tomaszkowal/logic_nixie_clock/logic_nixie_clock.kicad_pcb

## KiCad design logic_nixie_clock.kicad_pcb (2026-10-22)

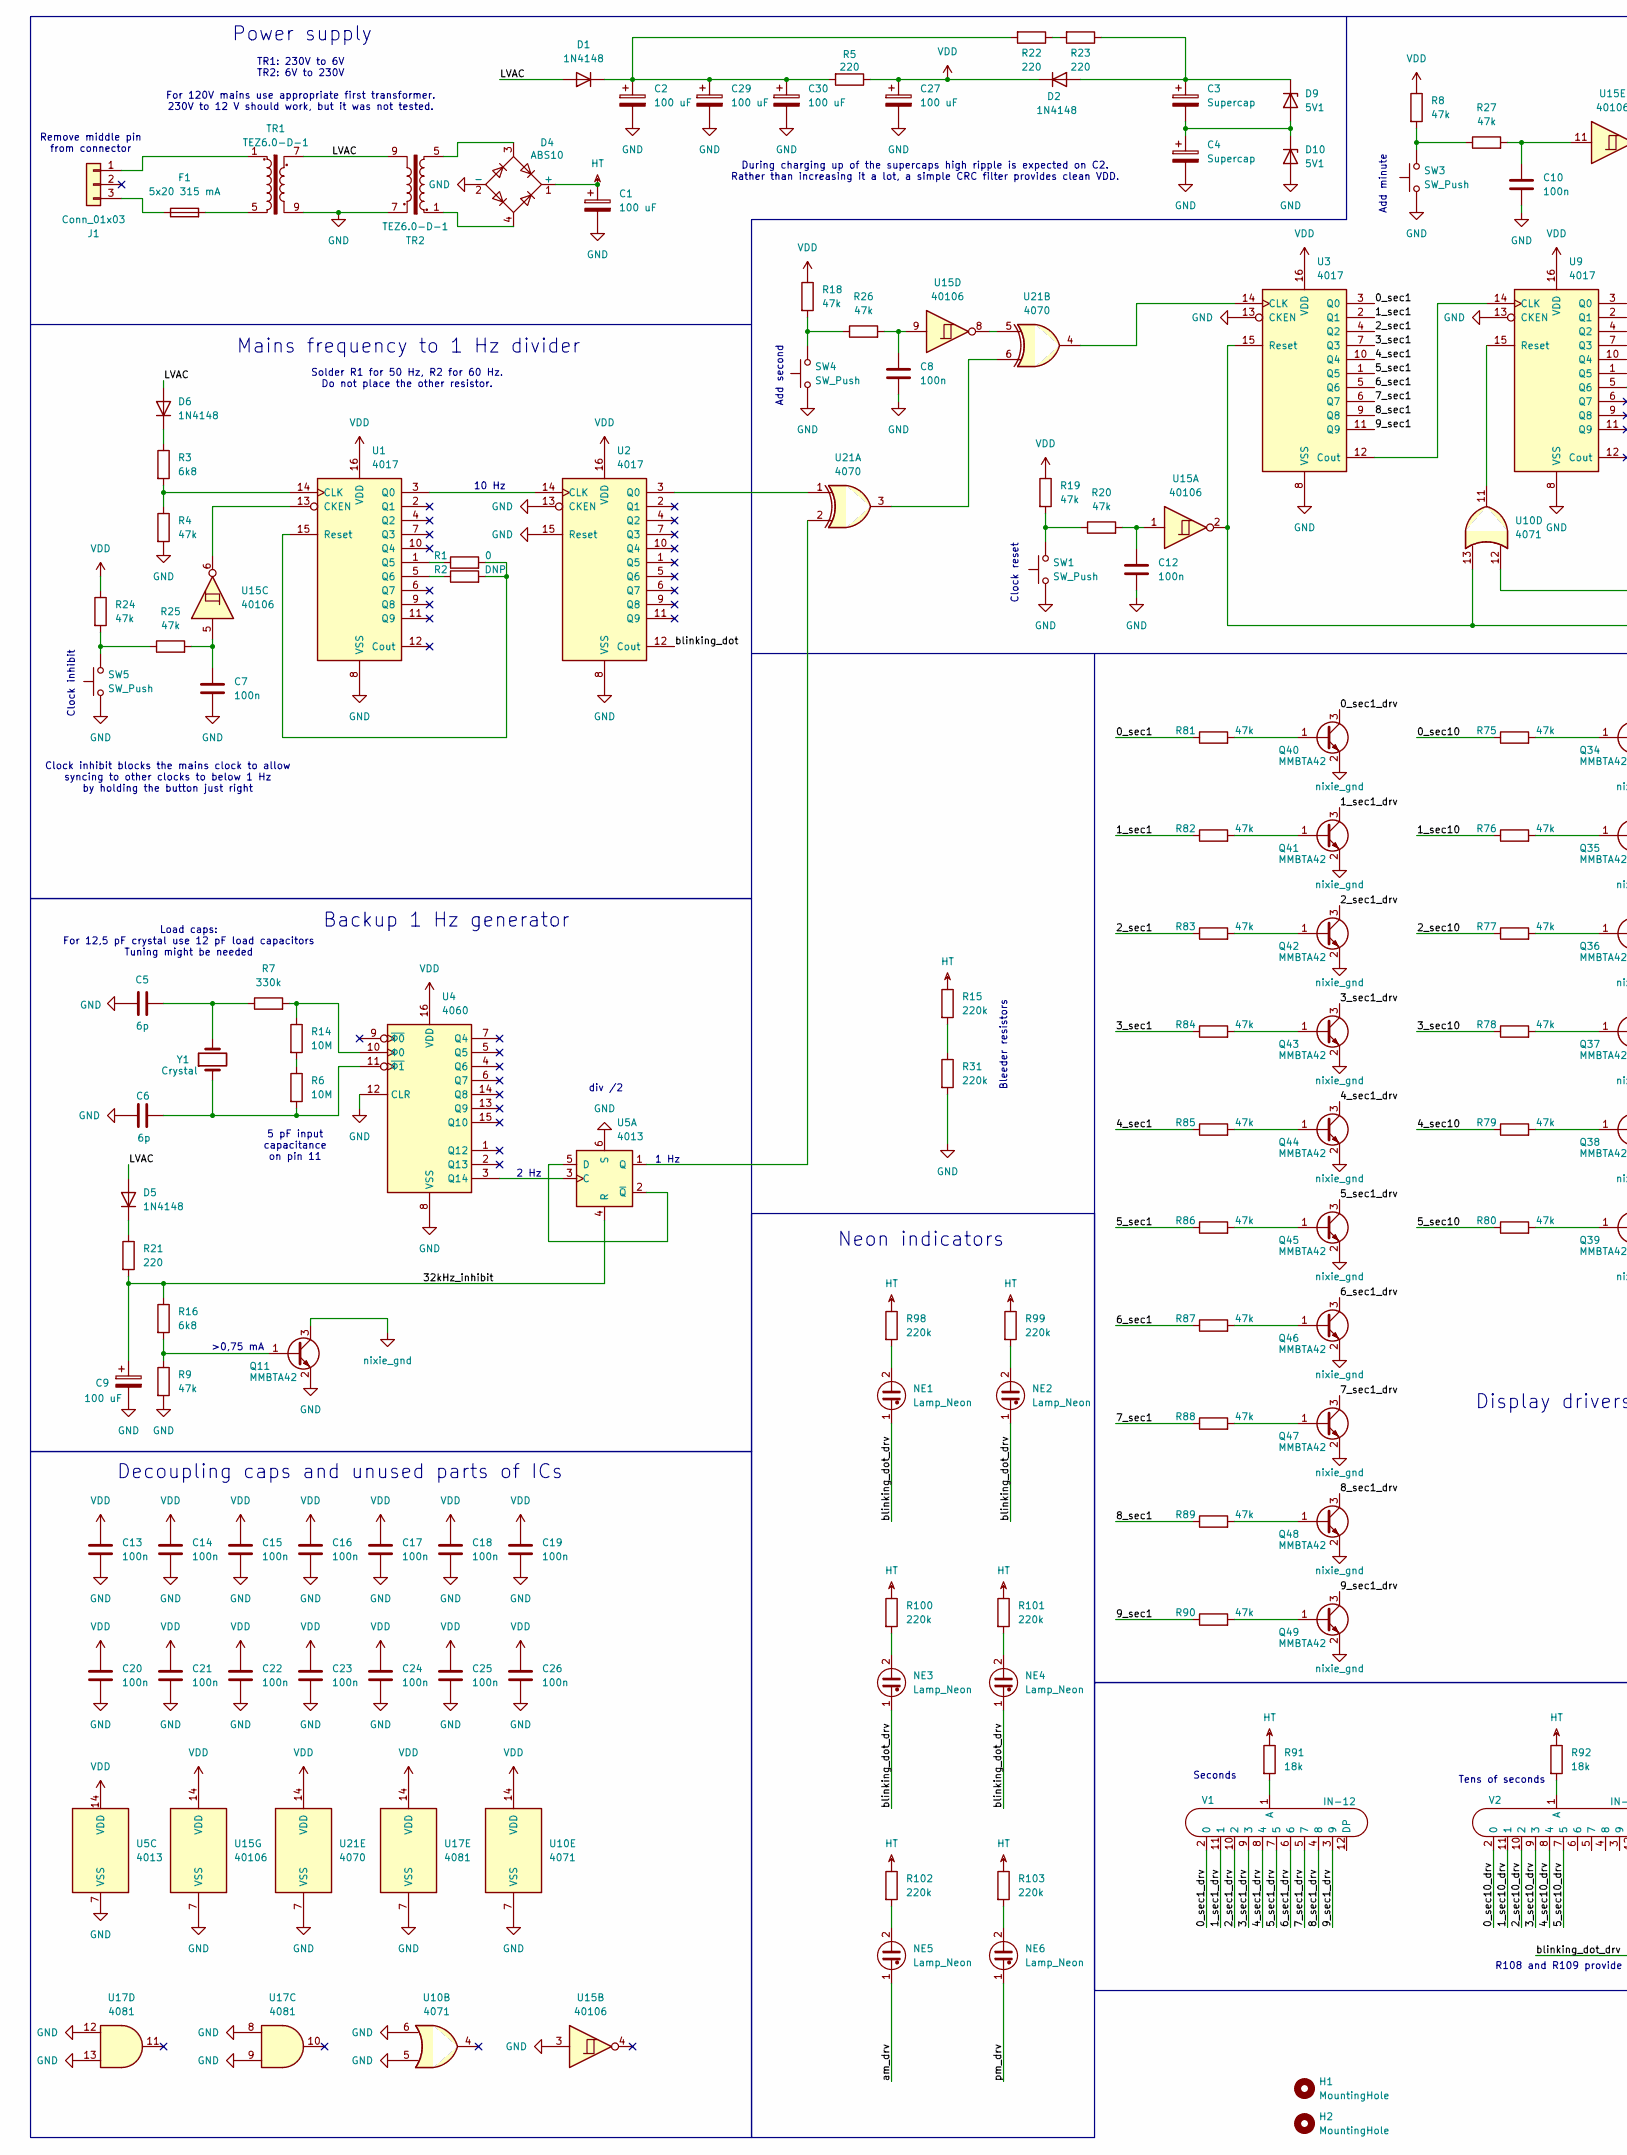
[picture p1: schematic logic_nixie_clock.kicad_sch, 4000 series logic nixie clock, part in row 1, column 1]

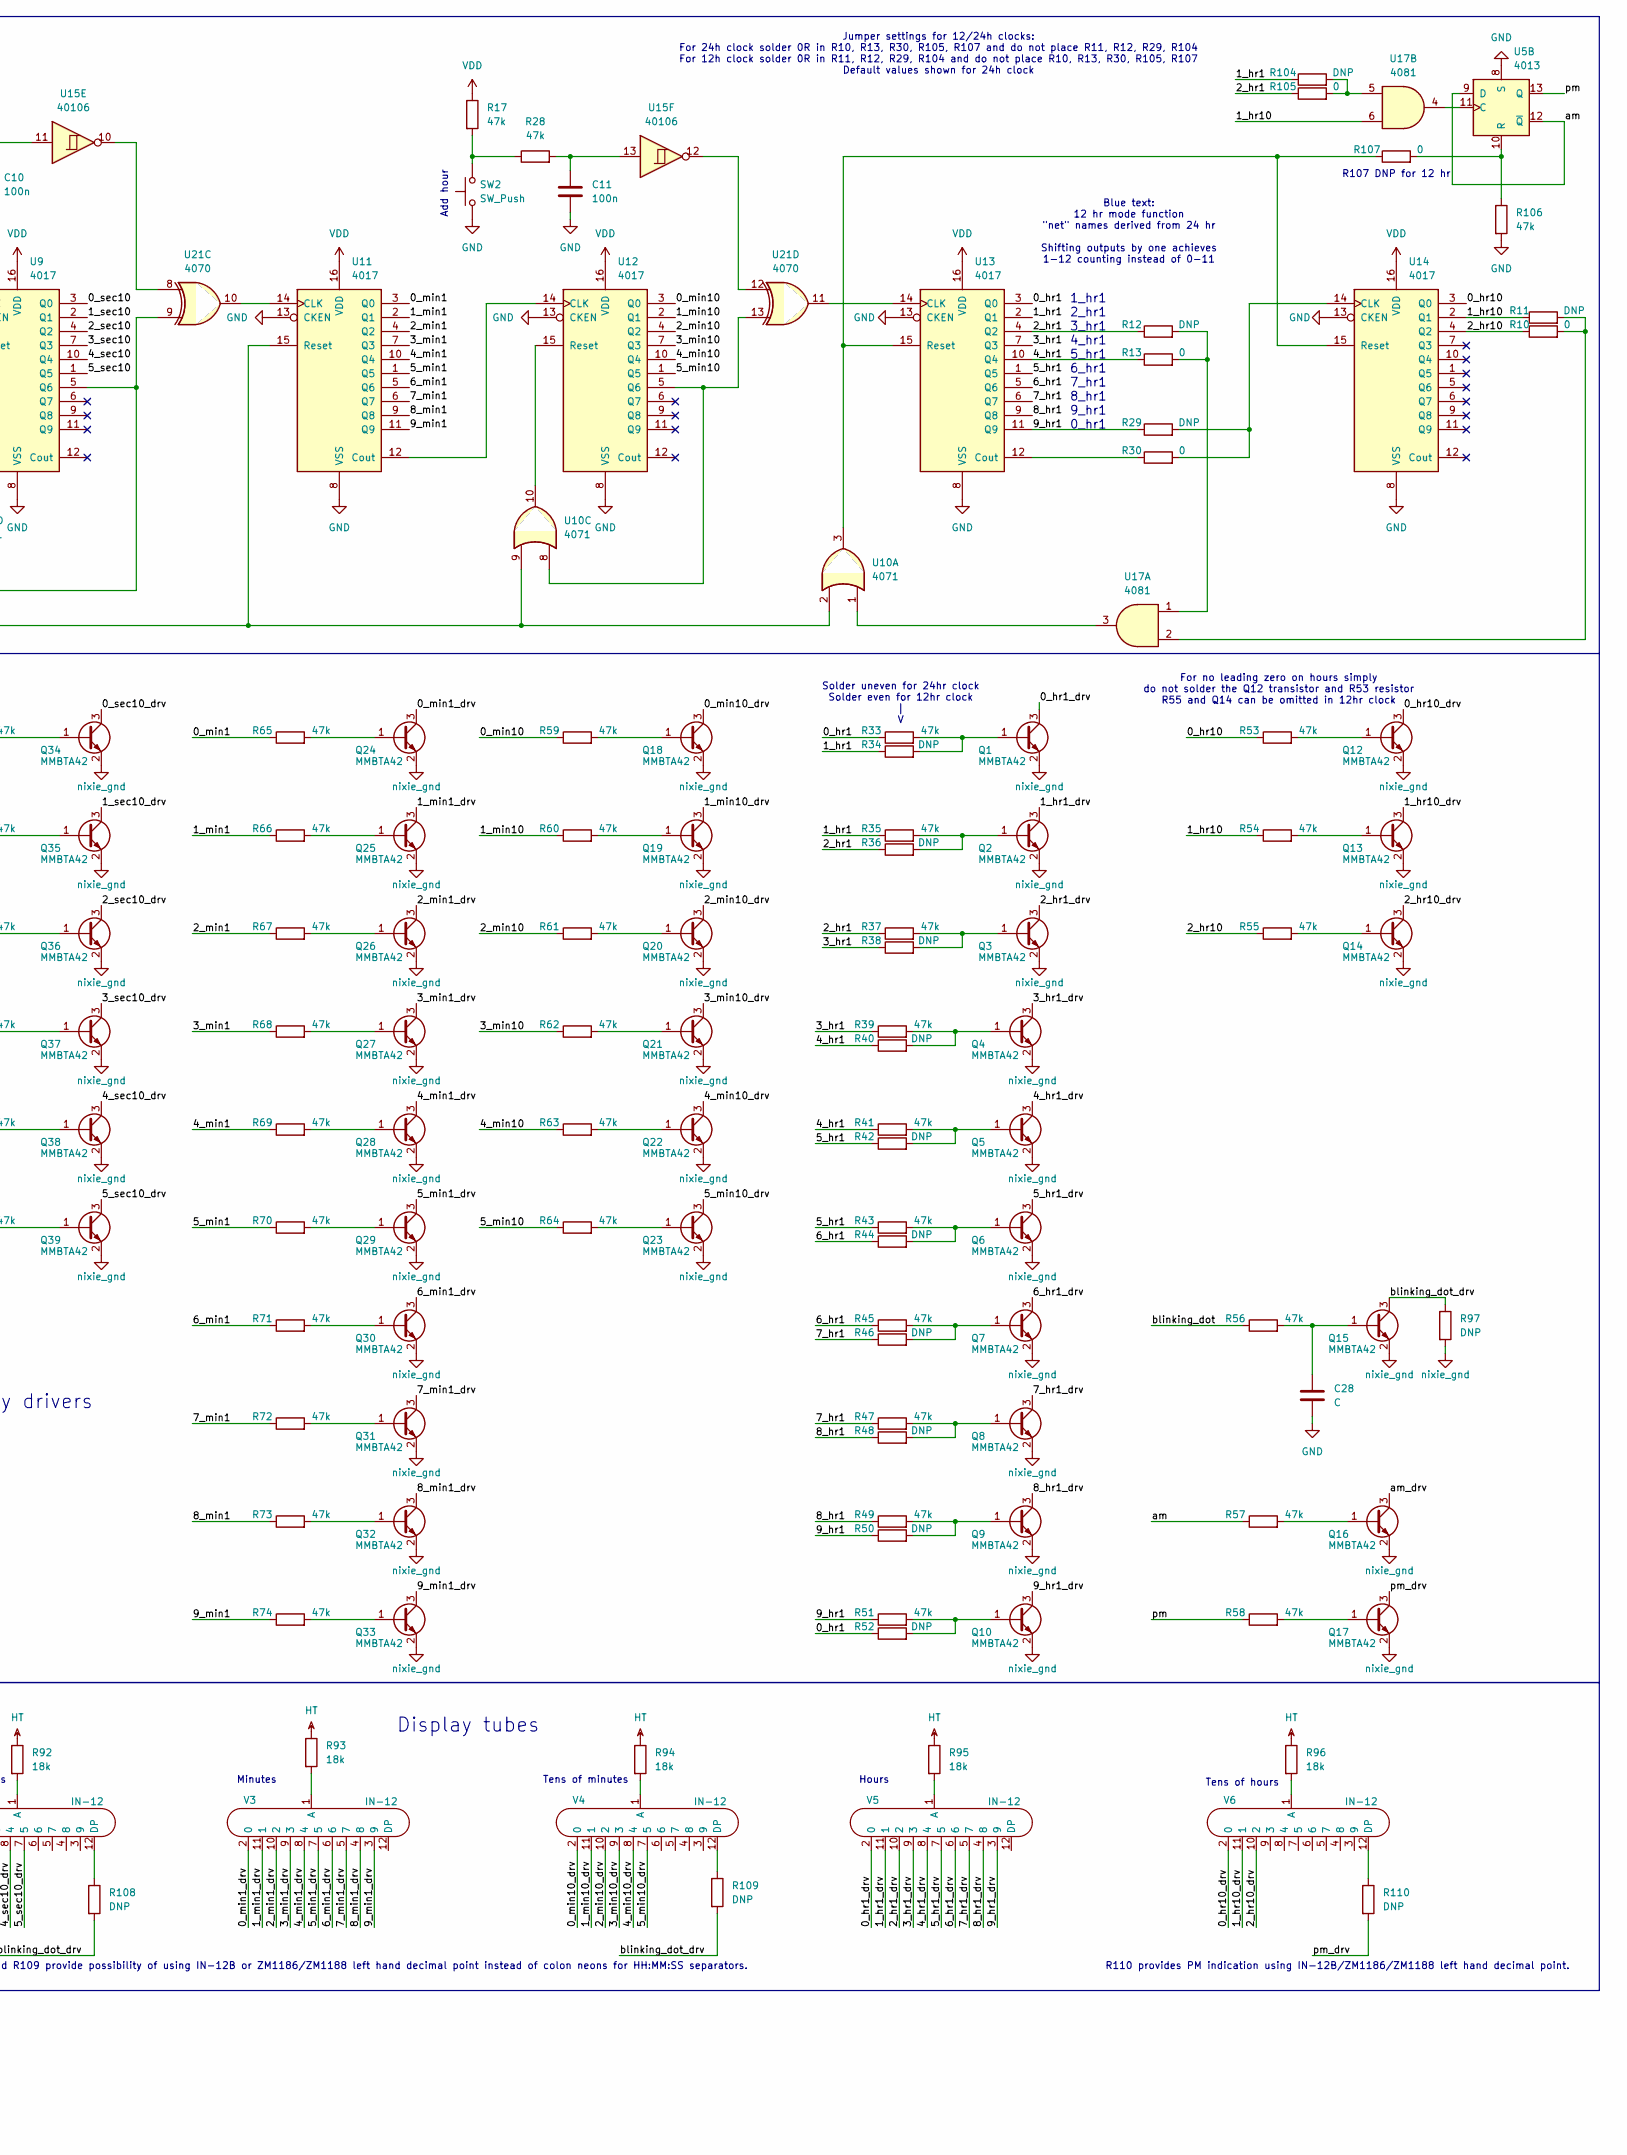
[picture p2: schematic logic_nixie_clock.kicad_sch, 4000 series logic nixie clock, part in row 1, column 2]

Parts:
C1: 100 uF; CP_Radial_D16.0mm_P7.50mm
C2, C9, C27, C29, C30: 100 uF; CP_Radial_D5.0mm_P2.00mm
C3, C4: Supercap; 17x25x8,5mm double supercapacitor
C5, C6: 6p; C_0805_2012Metric_Pad1.18x1.45mm_HandSolder
C7, C8, C10, C11, C12, C13, C14, C15, C16, C17, C18, C19, C20, C21, C22, C23, C24, C25, C26: 100n; C_0805_2012Metric_Pad1.18x1.45mm_HandSolder
C28: C; C_0805_2012Metric_Pad1.18x1.45mm_HandSolder
D1, D2, D5, D6: 1N4148; D_SOD-123F
D4: ABS10; Diode_Bridge_Diotec_ABS
D9, D10: 5V1; D_MiniMELF
F1: 5x20 315 mA; Fuseholder_Clip-5x20mm_Schurter_CQM_Inline_P20.60x5.00mm_D1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
H1, H2: MountingHole; MountingHole_3.2mm_M3
J1: Conn_01x03; JST_VH_B3P-VH-B_1x03_P3.96mm_Vertical
NE1, NE2, NE3, NE4, NE5, NE6: Lamp_Neon; NE-2 4mm
Q1, Q2, Q3, Q4, Q5, Q6, Q7, Q8, Q9, Q10, Q11, Q12, Q13, Q14, Q15, Q16, Q17, Q18, Q19, Q20, Q21, Q22, Q23, Q24, Q25, Q26, Q27, Q28, Q29, Q30, Q31, Q32, Q33, Q34, Q35, Q36, Q37, Q38, Q39, Q40, Q41, Q42, Q43, Q44, Q45, Q46, Q47, Q48, Q49: MMBTA42; SOT-23-3
R1, R10, R13, R30, R105, R107: 0; R_0805_2012Metric_Pad1.20x1.40mm_HandSolder
R2, R11, R12, R29, R34, R36, R38, R40, R42, R44, R46, R48, R50, R52, R97, R104: DNP; R_0805_2012Metric_Pad1.20x1.40mm_HandSolder
R3, R16: 6k8; R_0805_2012Metric_Pad1.20x1.40mm_HandSolder
R4, R8, R9, R17, R18, R19, R20, R24, R25, R26, R27, R28, R33, R35, R37, R39, R41, R43, R45, R47, R49, R51, R53, R54, R55, R56, R57, R58, R59, R60, R61, R62, R63, R64, R65, R66, R67, R68, R69, R70, R71, R72, R73, R74, R75, R76, R77, R78, R79, R80, R81, R82, R83, R84, R85, R86, R87, R88, R89, R90, R106: 47k; R_0805_2012Metric_Pad1.20x1.40mm_HandSolder
R5, R21, R22, R23: 220; R_0805_2012Metric_Pad1.20x1.40mm_HandSolder
R6, R14: 10M; R_0805_2012Metric_Pad1.20x1.40mm_HandSolder
R7: 330k; R_0805_2012Metric_Pad1.20x1.40mm_HandSolder
R15, R31, R98, R99, R100, R101, R102, R103: 220k; R_1206_3216Metric_Pad1.30x1.75mm_HandSolder
R91, R92, R93, R94, R95, R96: 18k; R_1206_3216Metric_Pad1.30x1.75mm_HandSolder
R108, R109, R110: DNP; R_1206_3216Metric_Pad1.30x1.75mm_HandSolder
SW1, SW2, SW3, SW4, SW5: SW_Push; SW_Tactile_SPST_Angled_PTS645Vx58-2LFS
TR1, TR2: TEZ6.0-D-1; Transformer_Breve_TEZ-38x45
U1, U2, U3, U9, U11, U12, U13, U14: 4017; SO-16_3.9x9.9mm_P1.27mm
U4: 4060; SO-16_3.9x9.9mm_P1.27mm
U5: 4013; SO-14_3.9x8.65mm_P1.27mm
U10: 4071; SO-14_3.9x8.65mm_P1.27mm
U15: 40106; SO-14_3.9x8.65mm_P1.27mm
U17: 4081; SO-14_3.9x8.65mm_P1.27mm
U21: 4070; SO-14_3.9x8.65mm_P1.27mm
V1, V2, V3, V4, V5, V6: IN-12; IN-12_ZM1180_universal
Y1: Crystal; Crystal_C38-LF_D3.0mm_L8.0mm_Vertical

Connections:
/0_hr1: R33.1, R52.1, U13.3 (Q0)
/0_hr1_drv: Q1.3 (C), V5.2 (0)
/0_hr10: R53.1, U14.3 (Q0)
/0_hr10_drv: Q12.3 (C), V6.2 (0)
/0_min1: R65.1, U11.3 (Q0)
/0_min1_drv: Q24.3 (C), V3.2 (0)
/0_min10: R59.1, U12.3 (Q0)
/0_min10_drv: Q18.3 (C), V4.2 (0)
/0_sec1: R81.1, U3.3 (Q0)
/0_sec1_drv: Q40.3 (C), V1.2 (0)
/0_sec10: R75.1, U9.3 (Q0)
/0_sec10_drv: Q34.3 (C), V2.2 (0)
/1_hr1: R34.1, R35.1, R104.1, U13.2 (Q1)
/1_hr1_drv: Q2.3 (C), V5.11 (1)
/1_hr10: R11.1, R54.1, U14.2 (Q1), U17.6
/1_hr10_drv: Q13.3 (C), V6.11 (1)
/1_min1: R66.1, U11.2 (Q1)
/1_min1_drv: Q25.3 (C), V3.11 (1)
/1_min10: R60.1, U12.2 (Q1)
/1_min10_drv: Q19.3 (C), V4.11 (1)
/1_sec1: R82.1, U3.2 (Q1)
/1_sec1_drv: Q41.3 (C), V1.11 (1)
/1_sec10: R76.1, U9.2 (Q1)
/1_sec10_drv: Q35.3 (C), V2.11 (1)
/2_hr1: R12.1, R36.1, R37.1, R105.1, U13.4 (Q2)
/2_hr1_drv: Q3.3 (C), V5.10 (2)
/2_hr10: R10.1, R55.1, U14.4 (Q2)
/2_hr10_drv: Q14.3 (C), V6.10 (2)
/2_min1: R67.1, U11.4 (Q2)
/2_min1_drv: Q26.3 (C), V3.10 (2)
/2_min10: R61.1, U12.4 (Q2)
/2_min10_drv: Q20.3 (C), V4.10 (2)
/2_sec1: R83.1, U3.4 (Q2)
/2_sec1_drv: Q42.3 (C), V1.10 (2)
/2_sec10: R77.1, U9.4 (Q2)
/2_sec10_drv: Q36.3 (C), V2.10 (2)
/3_hr1: R38.1, R39.1, U13.7 (Q3)
/3_hr1_drv: Q4.3 (C), V5.9 (3)
/3_min1: R68.1, U11.7 (Q3)
/3_min1_drv: Q27.3 (C), V3.9 (3)
/3_min10: R62.1, U12.7 (Q3)
/3_min10_drv: Q21.3 (C), V4.9 (3)
/3_sec1: R84.1, U3.7 (Q3)
/3_sec1_drv: Q43.3 (C), V1.9 (3)
/3_sec10: R78.1, U9.7 (Q3)
/3_sec10_drv: Q37.3 (C), V2.9 (3)
/4_hr1: R13.1, R40.1, R41.1, U13.10 (Q4)
/4_hr1_drv: Q5.3 (C), V5.8 (4)
/4_min1: R69.1, U11.10 (Q4)
/4_min1_drv: Q28.3 (C), V3.8 (4)
/4_min10: R63.1, U12.10 (Q4)
/4_min10_drv: Q22.3 (C), V4.8 (4)
/4_sec1: R85.1, U3.10 (Q4)
/4_sec1_drv: Q44.3 (C), V1.8 (4)
/4_sec10: R79.1, U9.10 (Q4)
/4_sec10_drv: Q38.3 (C), V2.8 (4)
/5_hr1: R42.1, R43.1, U13.1 (Q5)
/5_hr1_drv: Q6.3 (C), V5.7 (5)
/5_min1: R70.1, U11.1 (Q5)
/5_min1_drv: Q29.3 (C), V3.7 (5)
/5_min10: R64.1, U12.1 (Q5)
/5_min10_drv: Q23.3 (C), V4.7 (5)
/5_sec1: R86.1, U3.1 (Q5)
/5_sec1_drv: Q45.3 (C), V1.7 (5)
/5_sec10: R80.1, U9.1 (Q5)
/5_sec10_drv: Q39.3 (C), V2.7 (5)
/6_hr1: R44.1, R45.1, U13.5 (Q6)
/6_hr1_drv: Q7.3 (C), V5.6
/6_min1: R71.1, U11.5 (Q6)
/6_min1_drv: Q30.3 (C), V3.6
/6_sec1: R87.1, U3.5 (Q6)
/6_sec1_drv: Q46.3 (C), V1.6
/7_hr1: R46.1, R47.1, U13.6 (Q7)
/7_hr1_drv: Q8.3 (C), V5.5 (7)
/7_min1: R72.1, U11.6 (Q7)
/7_min1_drv: Q31.3 (C), V3.5 (7)
/7_sec1: R88.1, U3.6 (Q7)
/7_sec1_drv: Q47.3 (C), V1.5 (7)
/8_hr1: R48.1, R49.1, U13.9 (Q8)
/8_hr1_drv: Q9.3 (C), V5.4 (8)
/8_min1: R73.1, U11.9 (Q8)
/8_min1_drv: Q32.3 (C), V3.4 (8)
/8_sec1: R89.1, U3.9 (Q8)
/8_sec1_drv: Q48.3 (C), V1.4 (8)
/9_hr1: R29.1, R50.1, R51.1, U13.11 (Q9)
/9_hr1_drv: Q10.3 (C), V5.3 (9)
/9_min1: R74.1, U11.11 (Q9)
/9_min1_drv: Q33.3 (C), V3.3 (9)
/9_sec1: R90.1, U3.11 (Q9)
/9_sec1_drv: Q49.3 (C), V1.3 (9)
/32kHz_inhibit: C9.1, R16.1, R21.2, U5.4 (R)
/LVAC: D1.2 (A), D5.2 (A), D6.2 (A), TR1.7, TR2.9
/am: R57.1, U5.9 (D), U5.12 (~Q)
/am_drv: NE5.1, Q16.3 (C)
/blinking_dot: R56.1, U2.12 (Cout)
/blinking_dot_drv: NE1.1, NE2.1, NE3.1, NE4.1, Q15.3 (C), R97.1, R108.2, R109.2
/pm: R58.1, U5.13 (Q)
/pm_drv: NE6.1, Q17.3 (C), R110.2
GND: C1.2, C2.2, C4.2, C5.1, C6.2, C7.2, C8.2, C9.2, C10.2, C11.2, C12.2, C13.2, C14.2, C15.2, C16.2, C17.2, C18.2, C19.2, C20.2, C21.2, C22.2, C23.2, C24.2, C25.2, C26.2, C27.2, C28.2, C29.2, C30.2, D4.2 (-), D10.2 (A), Q11.2 (E), R4.2, R9.2, R31.2, R106.2, SW1.1, SW2.1, SW3.1, SW4.1, SW5.1, TR1.9, TR2.7, U1.8 (VSS), U2.8 (VSS), U2.13 (CKEN), U2.15 (Reset), U3.8 (VSS), U3.13 (CKEN), U4.8 (VSS), U4.12 (CLR), U5.6 (S), U5.7 (VSS), U5.8 (S), U9.8 (VSS), U9.13 (CKEN), U10.5, U10.6, U10.7 (VSS), U11.8 (VSS), U11.13 (CKEN), U12.8 (VSS), U12.13 (CKEN), U13.8 (VSS), U13.13 (CKEN), U14.8 (VSS), U14.13 (CKEN), U15.3, U15.7 (VSS), U17.7 (VSS), U17.8, U17.9, U17.12, U17.13, U21.7 (VSS)
HT: C1.1, D4.1 (+), R15.1, R91.1, R92.1, R93.1, R94.1, R95.1, R96.1, R98.1, R99.1, R100.1, R101.1, R102.1, R103.1
unnamed: C5.2, R7.1, Y1.2
unnamed: C7.1, R25.2, U15.5
unnamed: C8.1, R26.2, U15.9
unnamed: C10.1, R27.2, U15.11
unnamed: C11.1, R28.2, U15.13
unnamed: C12.1, R20.2, U15.1
unnamed: C2.1, C29.1, C30.1, D1.1 (K), R5.2, R22.2
unnamed: C3.1, D2.2 (A), D9.1 (K), R23.1
unnamed: D4.3, TR2.5
unnamed: D4.4, TR2.1
unnamed: D5.1 (K), R21.1
unnamed: D6.1 (K), R3.1
unnamed: C3.2, C4.1, D9.2 (A), D10.1 (K)
unnamed: F1.2, TR1.5
unnamed: J1.1, TR1.1
unnamed: F1.1, J1.3
unnamed: NE1.2, R98.2
unnamed: NE2.2, R99.2
unnamed: NE3.2, R100.2
unnamed: NE4.2, R101.2
unnamed: NE5.2, R102.2
unnamed: NE6.2, R103.2
unnamed: Q1.1 (B), R33.2, R34.2
unnamed: Q2.1 (B), R35.2, R36.2
unnamed: Q3.1 (B), R37.2, R38.2
unnamed: Q4.1 (B), R39.2, R40.2
unnamed: Q5.1 (B), R41.2, R42.2
unnamed: Q6.1 (B), R43.2, R44.2
unnamed: Q7.1 (B), R45.2, R46.2
unnamed: Q8.1 (B), R47.2, R48.2
unnamed: Q9.1 (B), R49.2, R50.2
unnamed: Q10.1 (B), R51.2, R52.2
unnamed: Q11.1 (B), R9.1, R16.2
unnamed: Q12.1 (B), R53.2
unnamed: Q13.1 (B), R54.2
unnamed: Q14.1 (B), R55.2
unnamed: C28.1, Q15.1 (B), R56.2
unnamed: Q16.1 (B), R57.2
unnamed: Q17.1 (B), R58.2
unnamed: Q18.1 (B), R59.2
unnamed: Q19.1 (B), R60.2
unnamed: Q20.1 (B), R61.2
unnamed: Q21.1 (B), R62.2
unnamed: Q22.1 (B), R63.2
unnamed: Q23.1 (B), R64.2
unnamed: Q24.1 (B), R65.2
unnamed: Q25.1 (B), R66.2
unnamed: Q26.1 (B), R67.2
unnamed: Q27.1 (B), R68.2
unnamed: Q28.1 (B), R69.2
unnamed: Q29.1 (B), R70.2
unnamed: Q30.1 (B), R71.2
unnamed: Q31.1 (B), R72.2
unnamed: Q32.1 (B), R73.2
unnamed: Q33.1 (B), R74.2
unnamed: Q34.1 (B), R75.2
unnamed: Q35.1 (B), R76.2
unnamed: Q36.1 (B), R77.2
unnamed: Q37.1 (B), R78.2
unnamed: Q38.1 (B), R79.2
unnamed: Q39.1 (B), R80.2
unnamed: Q40.1 (B), R81.2
unnamed: Q41.1 (B), R82.2
unnamed: Q42.1 (B), R83.2
unnamed: Q43.1 (B), R84.2
unnamed: Q44.1 (B), R85.2
unnamed: Q45.1 (B), R86.2
unnamed: Q46.1 (B), R87.2
unnamed: Q47.1 (B), R88.2
unnamed: Q48.1 (B), R89.2
unnamed: Q49.1 (B), R90.2
unnamed: R10.2, R11.2, U17.2
unnamed: R12.2, R13.2, U17.1
unnamed: R6.1, R14.2
unnamed: R15.2, R31.1
unnamed: R17.2, R28.1, SW2.2
unnamed: R18.2, R26.1, SW4.2
unnamed: R19.2, R20.1, SW1.2
unnamed: R22.1, R23.2
unnamed: R24.2, R25.1, SW5.2
unnamed: R8.2, R27.1, SW3.2
unnamed: R104.2, R105.2, U17.5
unnamed: U1.13 (CKEN), U15.6
unnamed: R3.2, R4.1, U1.14 (CLK)
unnamed: U1.3 (Q0), U2.14 (CLK)
unnamed: R1.1, U1.1 (Q5)
unnamed: R2.1, U1.5 (Q6)
unnamed: R1.2, R2.2, U1.15 (Reset)
unnamed: U2.3 (Q0), U21.1
unnamed: U3.14 (CLK), U21.4
unnamed: U3.12 (Cout), U9.14 (CLK)
unnamed: U4.3 (Q14), U5.3 (C)
unnamed: C6.1, R6.2, U4.11 (~Φ1), Y1.1
unnamed: R7.2, R14.1, U4.10 (Φ0)
unnamed: U5.2 (~Q), U5.5 (D)
unnamed: U5.1 (Q), U21.2
unnamed: U5.11 (C), U17.4
unnamed: R106.1, R107.2, U5.10 (R)
unnamed: U9.5 (Q6), U10.12, U21.9
unnamed: U9.15 (Reset), U10.11
unnamed: U10.1, U17.3
unnamed: U11.14 (CLK), U21.10
unnamed: U11.12 (Cout), U12.14 (CLK)
unnamed: U3.15 (Reset), U10.2, U10.9, U10.13, U11.15 (Reset), U15.2
unnamed: U10.8, U12.5 (Q6), U21.13
unnamed: U10.10, U12.15 (Reset)
unnamed: U13.14 (CLK), U21.11
unnamed: R30.1, U13.12 (Cout)
unnamed: R107.1, U10.3, U13.15 (Reset), U14.15 (Reset)
unnamed: R29.2, R30.2, U14.14 (CLK)
unnamed: U15.8, U21.5
unnamed: U15.10, U21.8
unnamed: U15.12, U21.12
unnamed: U21.3, U21.6
unnamed: R91.2, V1.1 (A)
unnamed: R92.2, V2.1 (A)
unnamed: R108.1, V2.12 (DP)
unnamed: R93.2, V3.1 (A)
unnamed: R94.2, V4.1 (A)
unnamed: R109.1, V4.12 (DP)
unnamed: R95.2, V5.1 (A)
unnamed: R96.2, V6.1 (A)
unnamed: R110.1, V6.12 (DP)
VDD: C13.1, C14.1, C15.1, C16.1, C17.1, C18.1, C19.1, C20.1, C21.1, C22.1, C23.1, C24.1, C25.1, C26.1, C27.1, D2.1 (K), R5.1, R8.1, R17.1, R18.1, R19.1, R24.1, U1.16 (VDD), U2.16 (VDD), U3.16 (VDD), U4.16 (VDD), U5.14 (VDD), U9.16 (VDD), U10.14 (VDD), U11.16 (VDD), U12.16 (VDD), U13.16 (VDD), U14.16 (VDD), U15.14 (VDD), U17.14 (VDD), U21.14 (VDD)
nixie_gnd: Q1.2 (E), Q2.2 (E), Q3.2 (E), Q4.2 (E), Q5.2 (E), Q6.2 (E), Q7.2 (E), Q8.2 (E), Q9.2 (E), Q10.2 (E), Q11.3 (C), Q12.2 (E), Q13.2 (E), Q14.2 (E), Q15.2 (E), Q16.2 (E), Q17.2 (E), Q18.2 (E), Q19.2 (E), Q20.2 (E), Q21.2 (E), Q22.2 (E), Q23.2 (E), Q24.2 (E), Q25.2 (E), Q26.2 (E), Q27.2 (E), Q28.2 (E), Q29.2 (E), Q30.2 (E), Q31.2 (E), Q32.2 (E), Q33.2 (E), Q34.2 (E), Q35.2 (E), Q36.2 (E), Q37.2 (E), Q38.2 (E), Q39.2 (E), Q40.2 (E), Q41.2 (E), Q42.2 (E), Q43.2 (E), Q44.2 (E), Q45.2 (E), Q46.2 (E), Q47.2 (E), Q48.2 (E), Q49.2 (E), R97.2

Notes on the sheet:
Tens of hours
Minutes
R107 DNP for 12 hr
Solder uneven for 24hr clock Solder even for 12hr clock | V
Decoupling caps and unused parts of ICs
Backup 1 Hz generator
Add minute
R108 and R109 provide possibility of using IN-12B or ZM1186/ZM1188 left hand decimal point instead of colon neons for HH:MM:SS separators.
Tens of minutes
1_hr1 2_hr1 3_hr1 4_hr1 5_hr1 6_hr1 7_hr1 8_hr1 9_hr1 0_hr1
Load caps: For 12,5 pF crystal use 12 pF load capacitors Tuning might be needed
>0,75 mA
Solder R1 for 50 Hz, R2 for 60 Hz. Do not place the other resistor.
Bleeder resistors
Add hour
div /2
Blue text: 12 hr mode function "net" names derived from 24 hr Shifting outputs by one achieves 1-12 counting instead of 0-11
Neon indicators
Tens of seconds
Clock inhibit
2 Hz
TR1: 230V to 6V TR2: 6V to 230V For 120V mains use appropriate first transformer. 230V to 12 V should work, but it was not tested.
Jumper settings for 12/24h clocks: For 24h clock solder 0R in R10, R13, R30, R105, R107 and do not place R11, R12, R29, R104 For 12h clock solder 0R in R11, R12, R29, R104 and do not place R10, R13, R30, R105, R107 Default values shown for 24h clock
Power supply
Display drivers
10 Hz
Display tubes
5 pF input capacitance on pin 11
For no leading zero on hours simply do not solder the Q12 transistor and R53 resistor R55 and Q14 can be omitted in 12hr clock
Hours
During charging up of the supercaps high ripple is expected on C2. Rather than increasing it a lot, a simple CRC filter provides clean VDD.
Mains frequency to 1 Hz divider
Add second
Clock inhibit blocks the mains clock to allow syncing to other clocks to below 1 Hz by holding the button just right
Remove middle pin from connector
Seconds
R110 provides PM indication using IN-12B/ZM1186/ZM1188 left hand decimal point.
1 Hz
Clock reset

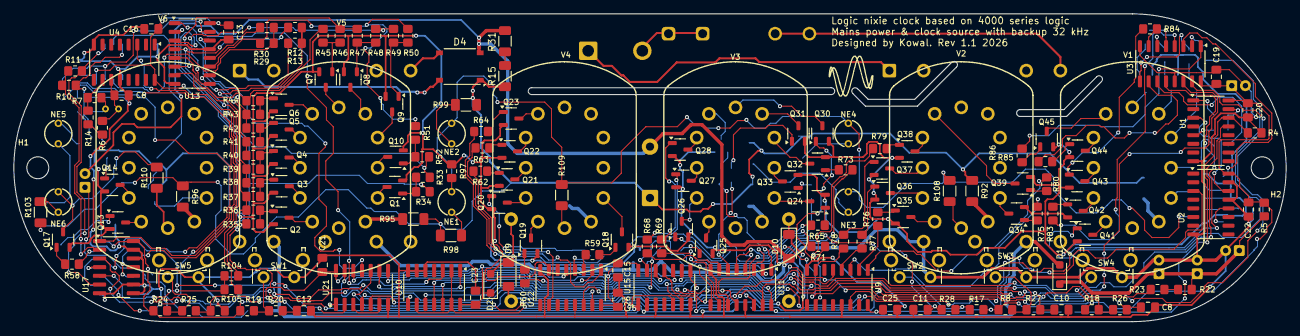
[picture p3: board logic_nixie_clock.kicad_pcb from above]

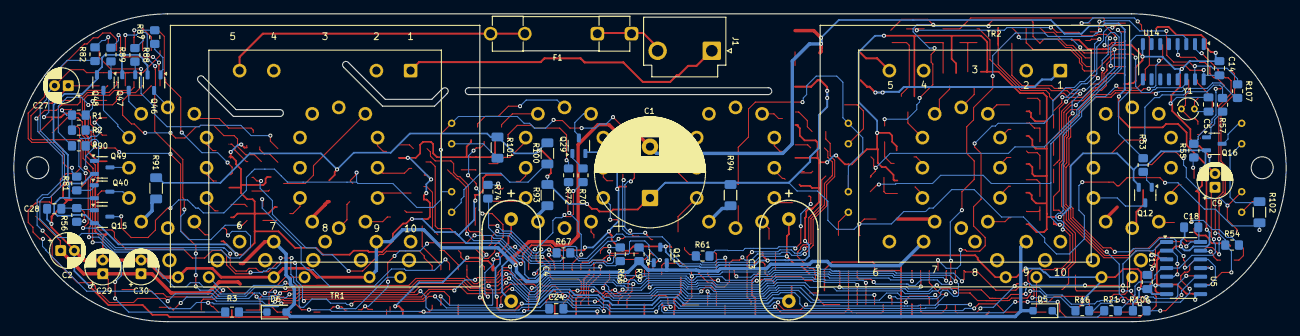
[picture p4: board logic_nixie_clock.kicad_pcb from below]

Board: 2 copper layers, 186.0 x 45.0 mm, 233 parts (64 on the bottom side), 225 nets.
